marcorispoli/PCB354/ESECUTIVI/LST/LST_PCB354_ASSY00_REV00.xlsx

Sheet: PCB354
# | Qty | Reference | Value | Package | NOTE
1 | 1 | IC1 | DRV8434RGER | VQFN
2 | 1 | Q1 | NTA4153NT1G | SC75-3
3 | 2 | R1,R2 | 10K | SMD 0603

Sheet: RELEASE
 | METALTRONICA S.p.a.
PCB/26-354-0 |  | ASSY 01
 |  | CS | CS/26-354-0
 |  |  | FR4 0.8mm | nr. LAYER 4 | 35µm
Revisione | Data | Descrizione
0 | 2026-11-04 | Prima emissione
