marcorispoli/PCB354/DOC/PCB244A-1-rev2.pdf

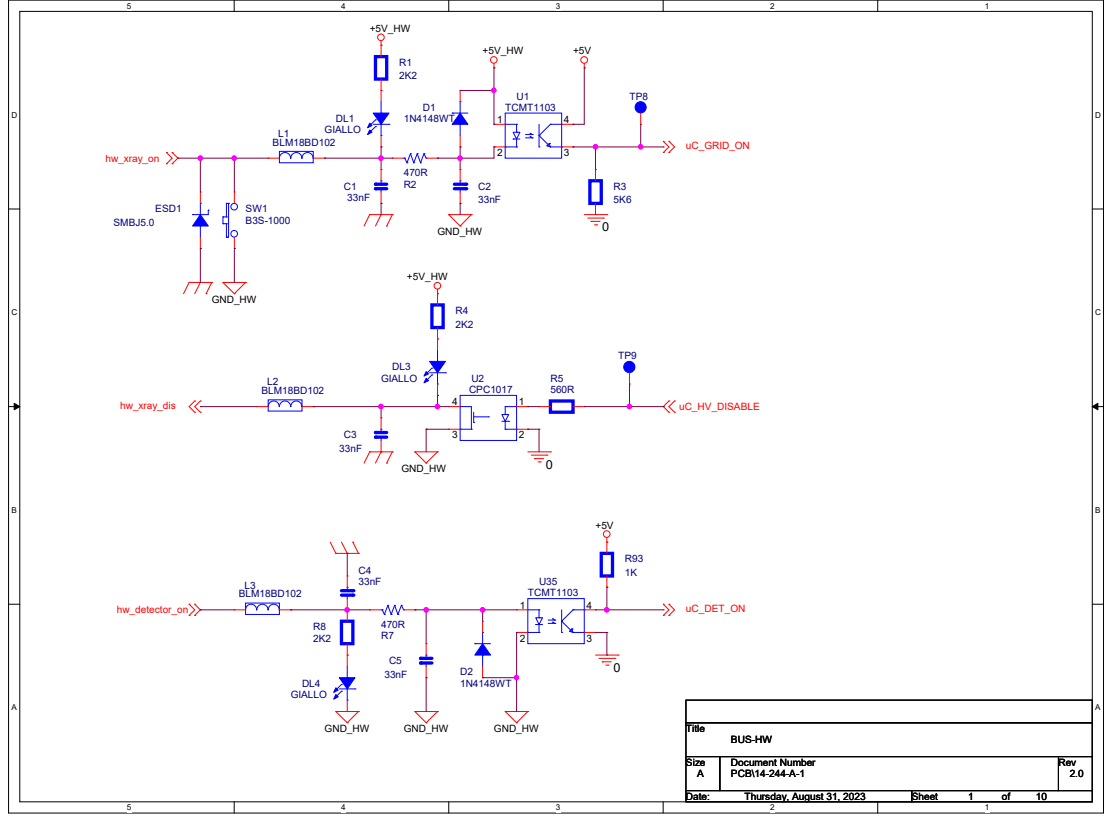
[picture p1: page 1]

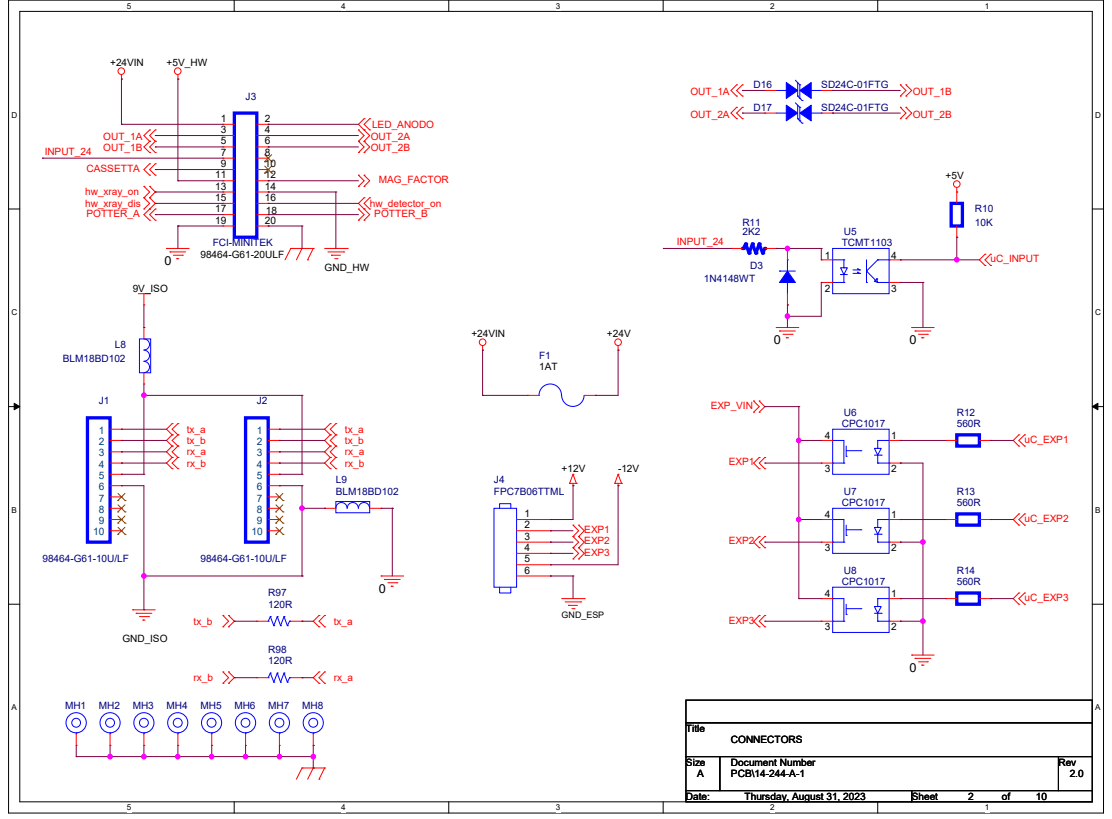
[picture p2: page 2]

## Vof=??V

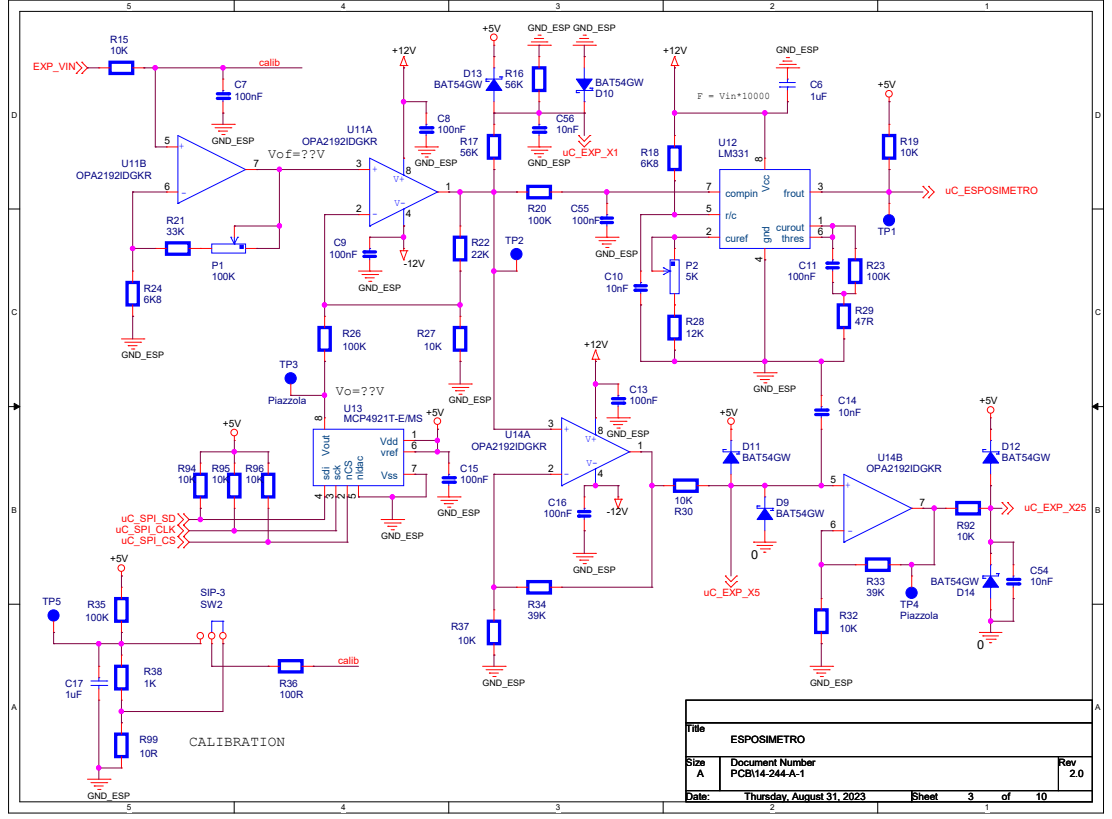
[picture p3: page 3]

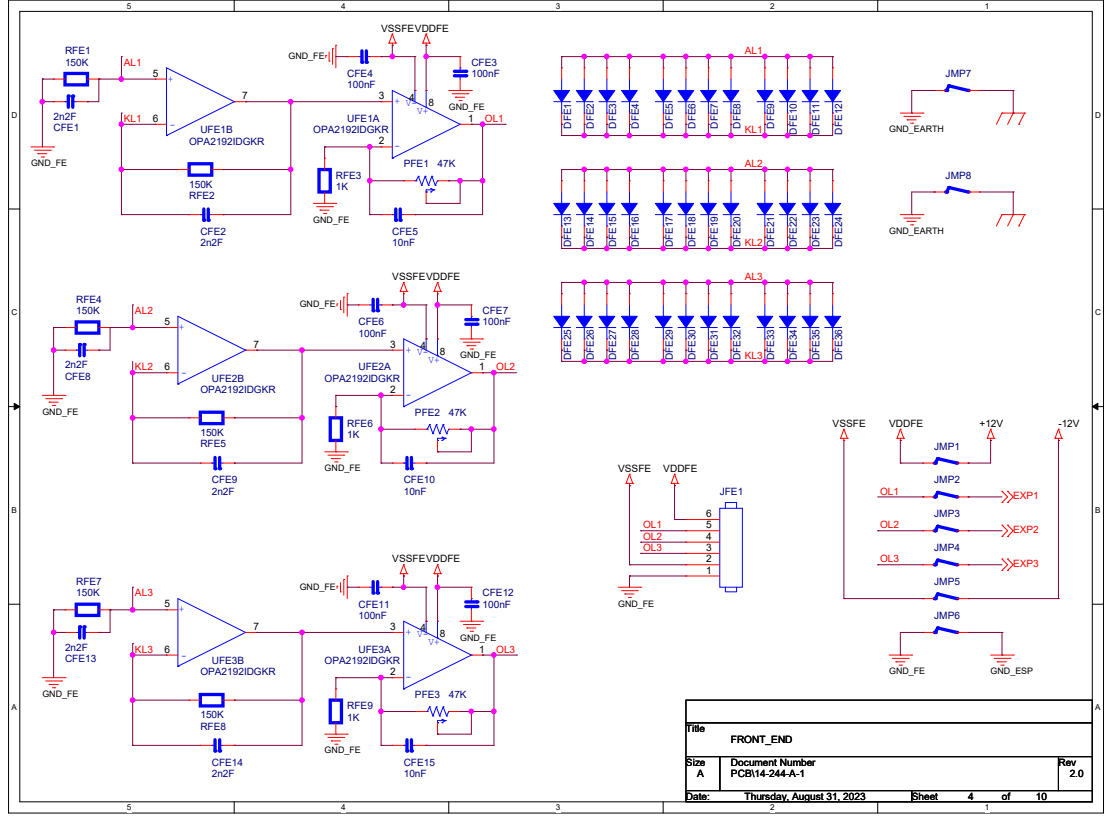
[picture p4: page 4]
VDDFE; GND_FE; VSSFE; VSSFEVDDFE; VSSFE VDDFE; GND_ESP; GND_EARTH; EXP1; EXP2; EXP3; Title; FRONT_END; Thursday, August 31, 2023; CFE1; DFE²⁰; DFE³⁵; JMP1 DFE⁶; JFE1; RFE9; DFE²⁶; PFE1 47K; RFE2; CFE9; DFE¹⁶; CFE12 100nF; V- V+ UFE3A; OPA2192IDGKR; DFE⁴; DFE³¹; DFE⁹; JMP5 DFE²¹; RFE5; CFE11 100nF; V- V+ UFE1A; RFE4; DFE³⁶; CFE3; DFE⁷ DFE²⁷; CFE10; DFE¹⁷; JMP8; JMP3 DFE³²; DFE¹⁰ DFE²²; RFE1 150K; - UFE2B OPA2192IDGKR; DFE¹³; DFE²; CFE13; DFE⁸ DFE²⁸; RFE3; DFE¹⁸; CFE4 100nF; V- V+ UFE2A; RFE6 1K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

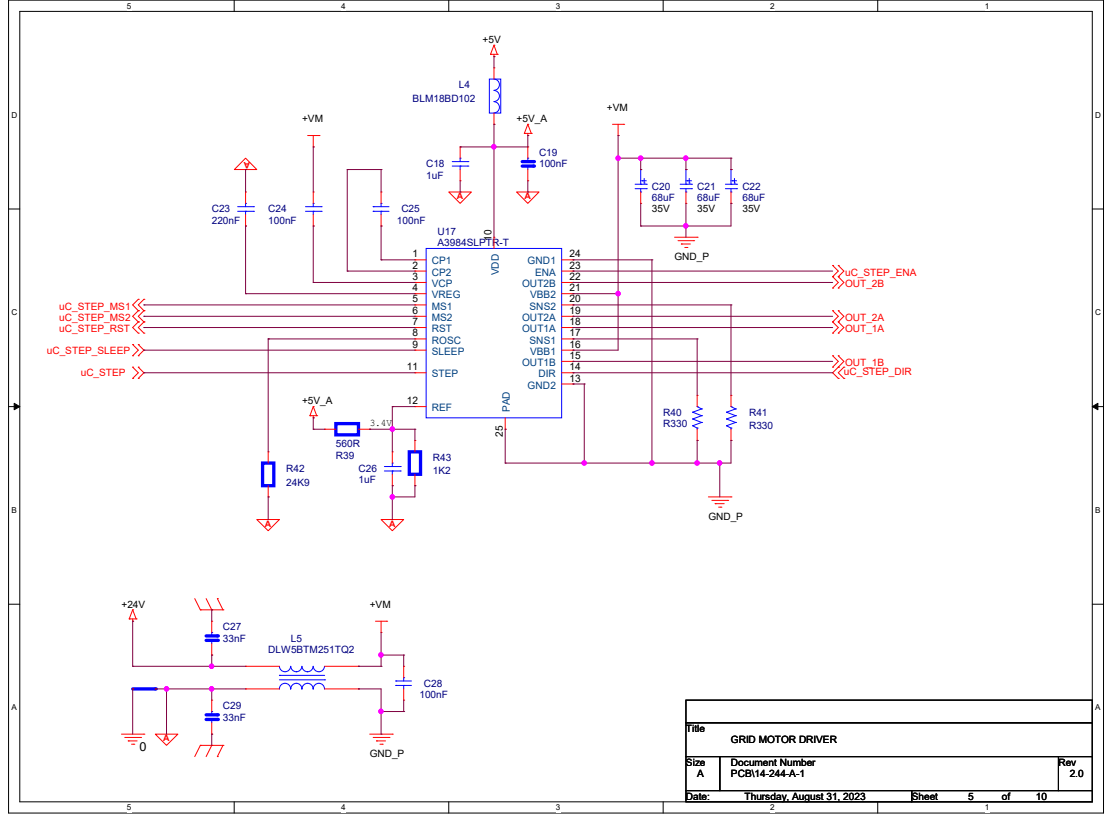
[picture p5: page 5]

0

# 2K2 _mclr_prg

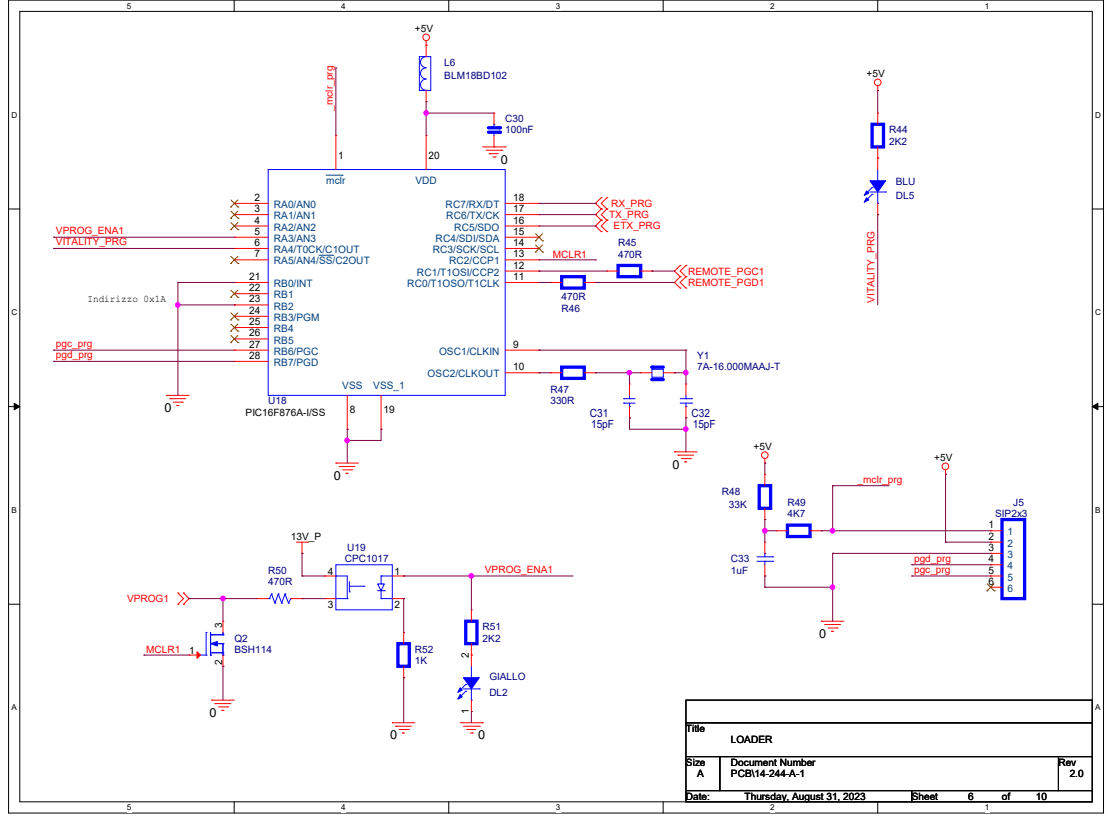
[picture p6: page 6]

VDD
RC1/T1OSI/CCP2 12 RC2/CCP1 13 RC3/SCK/SCL 14 RC4/SDI/SDA 15 RC5/SDO 16 RC6/TX/CK 17

0

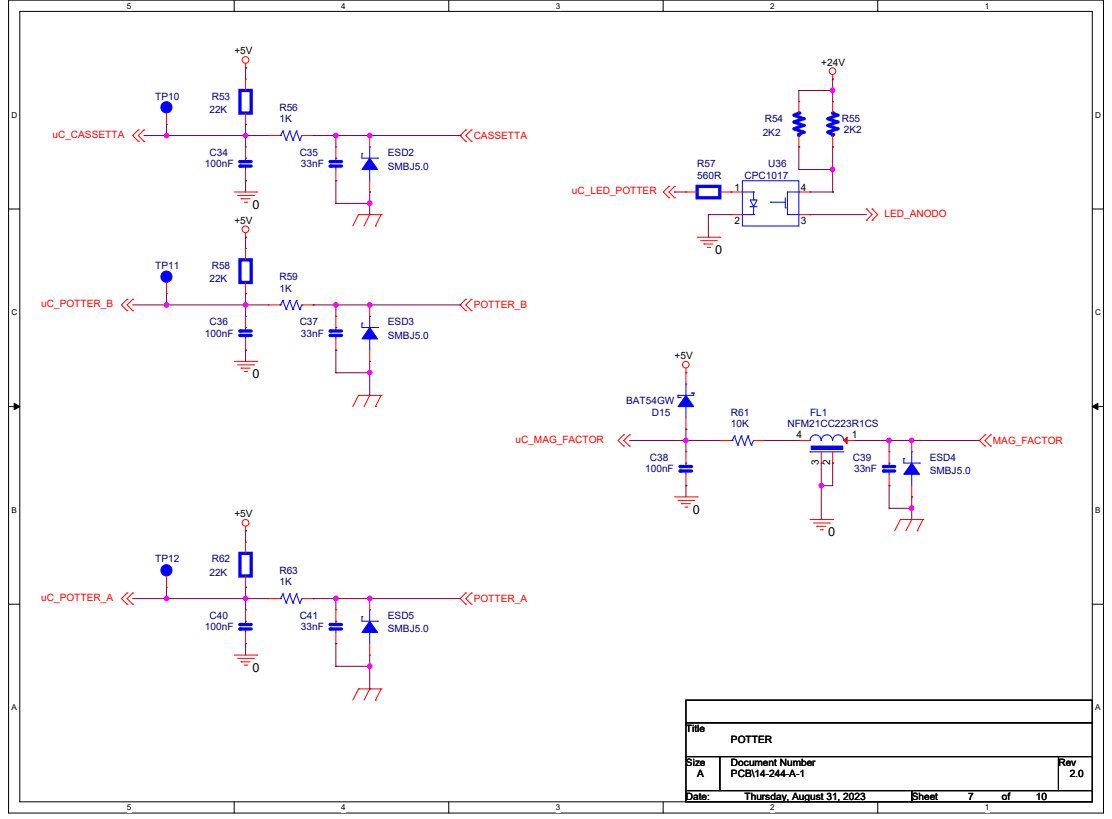
[picture p7: page 7]

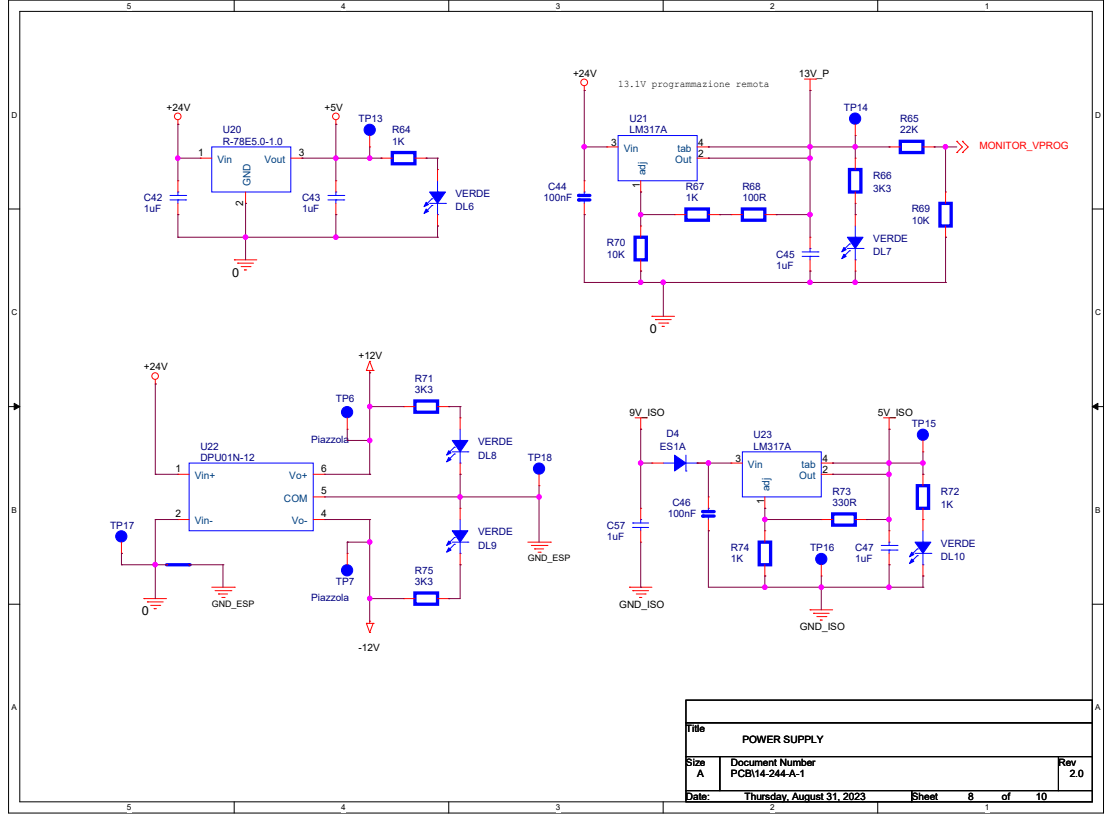
[picture p8: page 8]

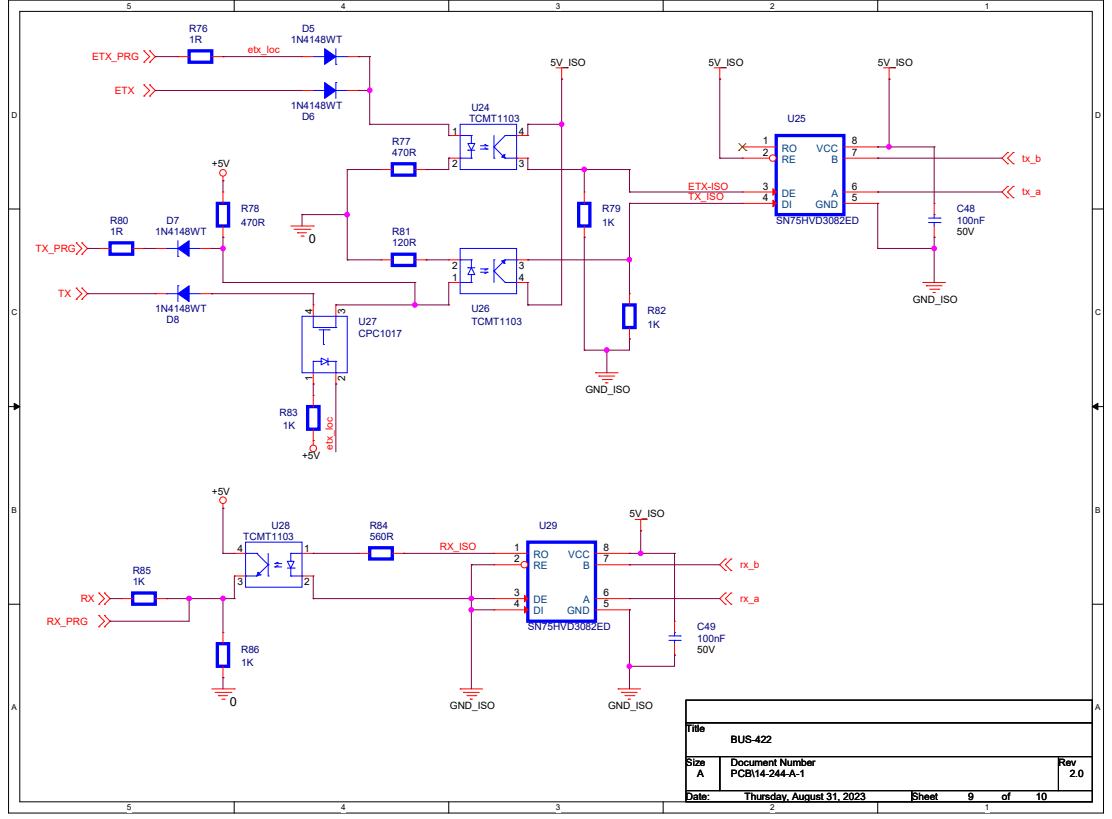
[picture p9: page 9]

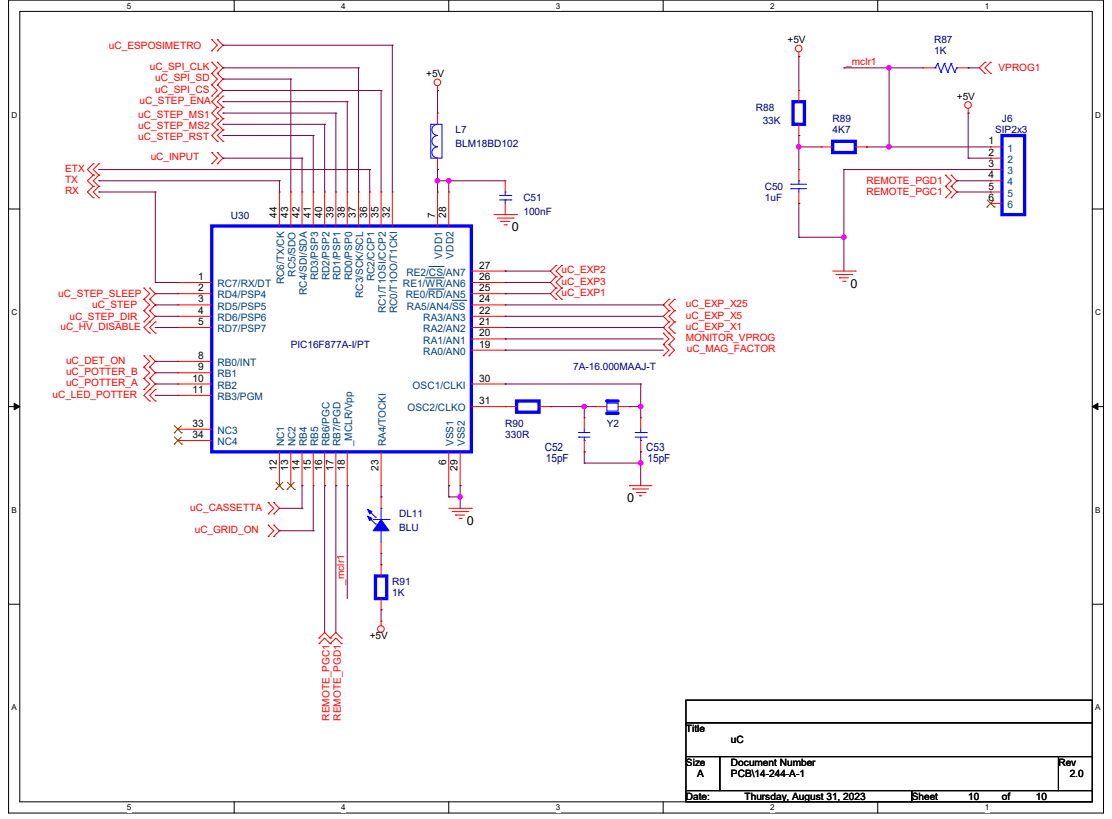
[picture p10: page 10]
