marcorispoli/PCB354/ESECUTIVI/SCH_26-354-0.pdf

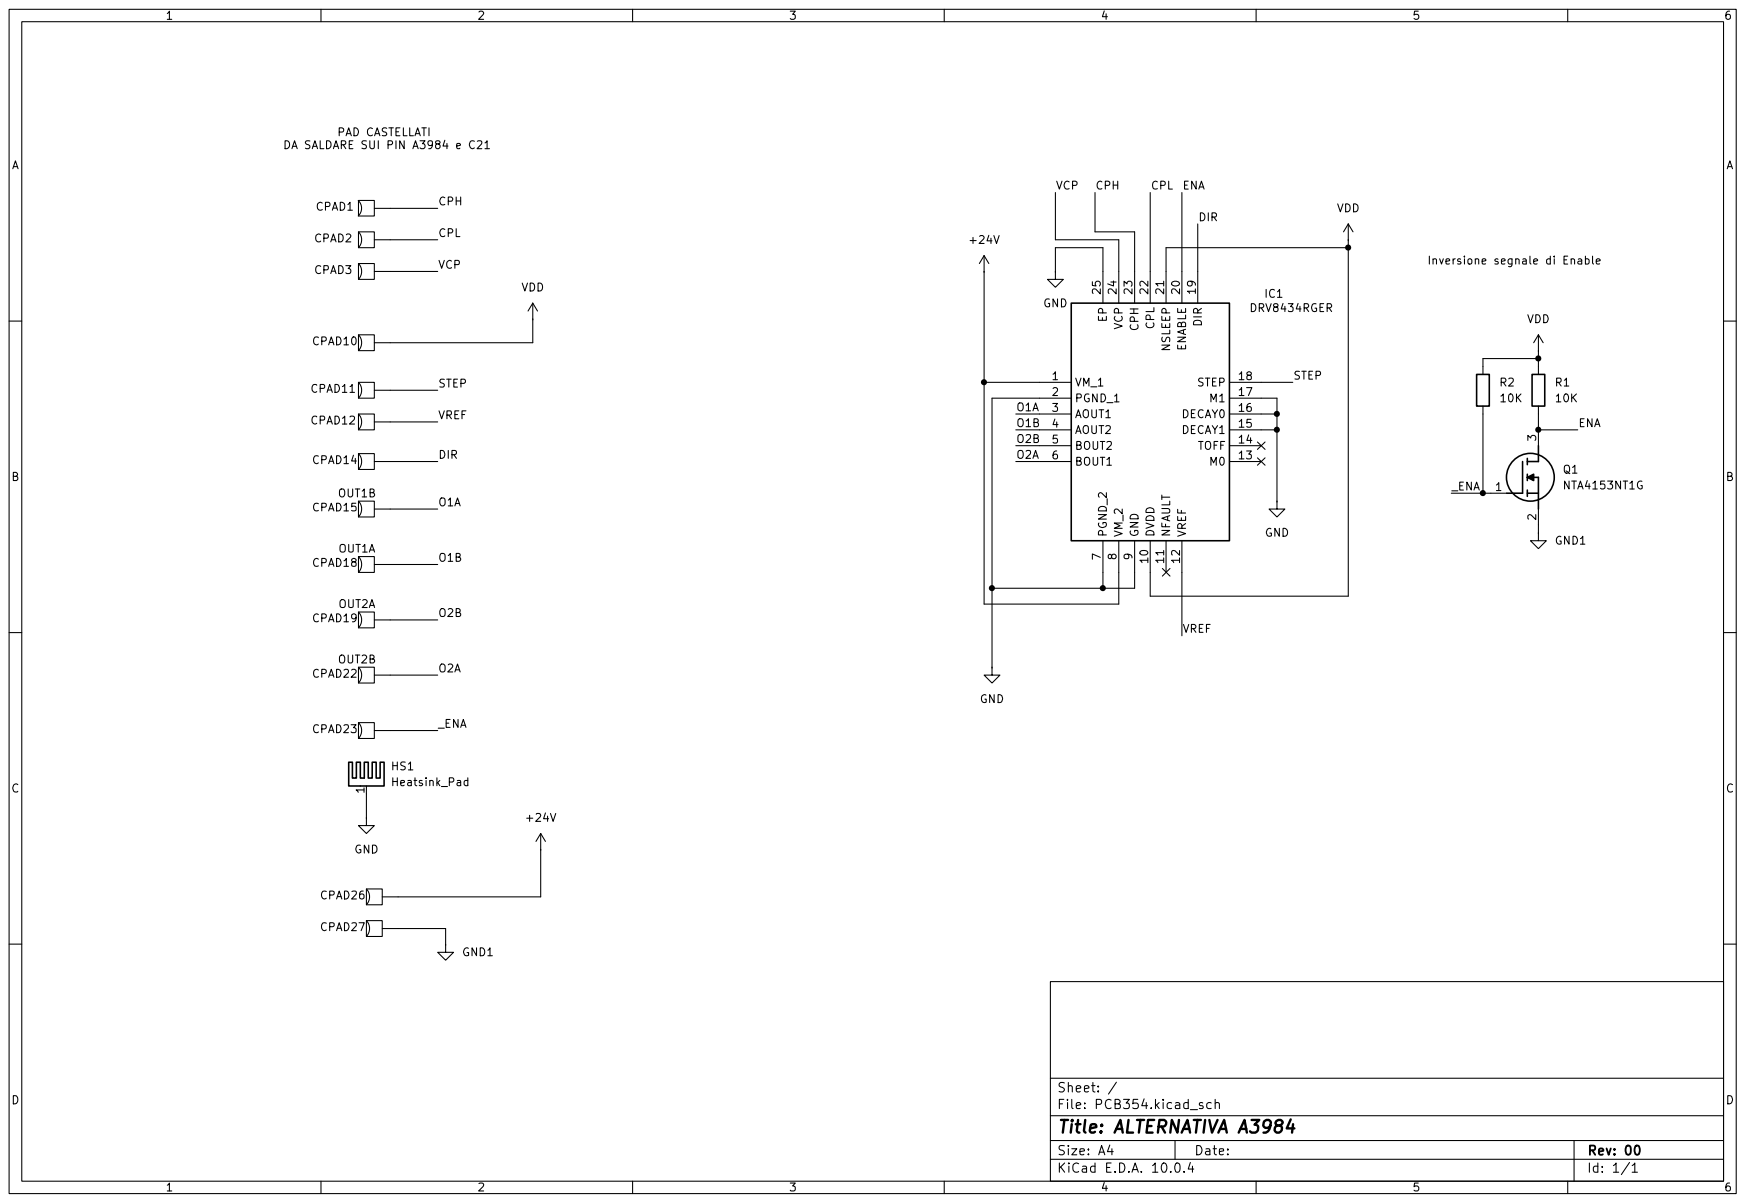
[picture p11: page 1]
