marcorispoli/PCB354/ESECUTIVI/PM_PCB354-0.pdf

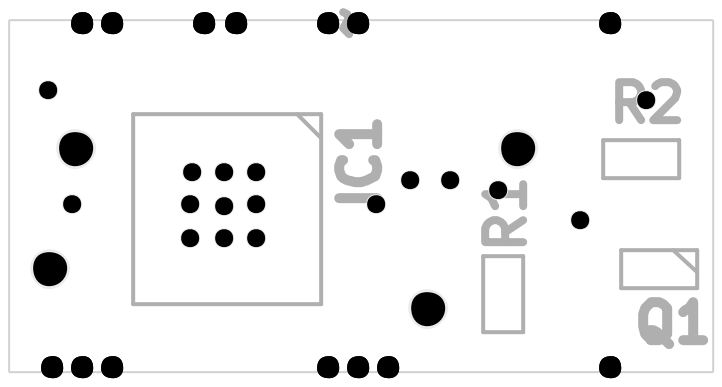
[picture p12: page 1]
