marcorispoli/PCB354/CAD/PCB354.kicad_pcb

## KiCad design CAD/PCB354.kicad_pcb (2026-11-04)

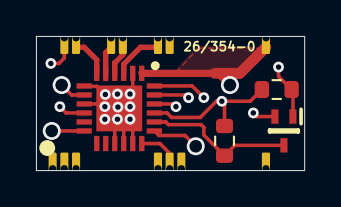
[picture p13: board PCB354.kicad_pcb from above]

Board: 4 copper layers, 14.9 x 7.5 mm, 19 parts (1 on the bottom side), 16 nets.

Parts:
CPAD1, CPAD2, CPAD3, CPAD10, CPAD11, CPAD12, CPAD14, CPAD15, CPAD18, CPAD19, CPAD22, CPAD23, CPAD26, CPAD27: Castellated_0.45x1
HS1: Heatsink_Pad; TestPoint_Pad_3.0x3.0mm
IC1: DRV8434RGER; DRV8434_QFN50P400X400X100-25N-D
Q1: NTA4153NT1G; MOS_NTA4153NT1G_SC75-3
R1, R2: 10K; R_0603_1608Metric

Connections:
+24V: CPAD26.1 (I_1), IC1.1 (VM_1), IC1.8 (VM_2)
/CPH: CPAD1.1 (I_1), IC1.23 (CPH)
/CPL: CPAD2.1 (I_1), IC1.22 (CPL)
/DIR: CPAD14.1 (I_1), IC1.19 (DIR)
/ENA: IC1.20 (ENABLE), Q1.3 (D), R1.2
/O1A: CPAD15.1 (I_1), IC1.3 (AOUT1)
/O1B: CPAD18.1 (I_1), IC1.4 (AOUT2)
/O2A: CPAD22.1 (I_1), IC1.6 (BOUT1)
/O2B: CPAD19.1 (I_1), IC1.5 (BOUT2)
/STEP: CPAD11.1 (I_1), IC1.18 (STEP)
/VCP: CPAD3.1 (I_1), IC1.24 (VCP)
/VREF: CPAD12.1 (I_1), IC1.12 (VREF)
/_ENA: CPAD23.1 (I_1), Q1.1 (G), R2.2
GND: HS1.1, IC1.2 (PGND_1), IC1.7 (PGND_2), IC1.9 (GND), IC1.15 (DECAY1), IC1.16 (DECAY0), IC1.17 (M1), IC1.25 (EP)
GND1: CPAD27.1 (I_1), Q1.2 (S)
VDD: CPAD10.1 (I_1), IC1.10 (DVDD), IC1.21 (NSLEEP), R1.1, R2.1
